chengfengwww/ESC/Hardware/SCH_Schematic1_1-P1_2025-06-22.png

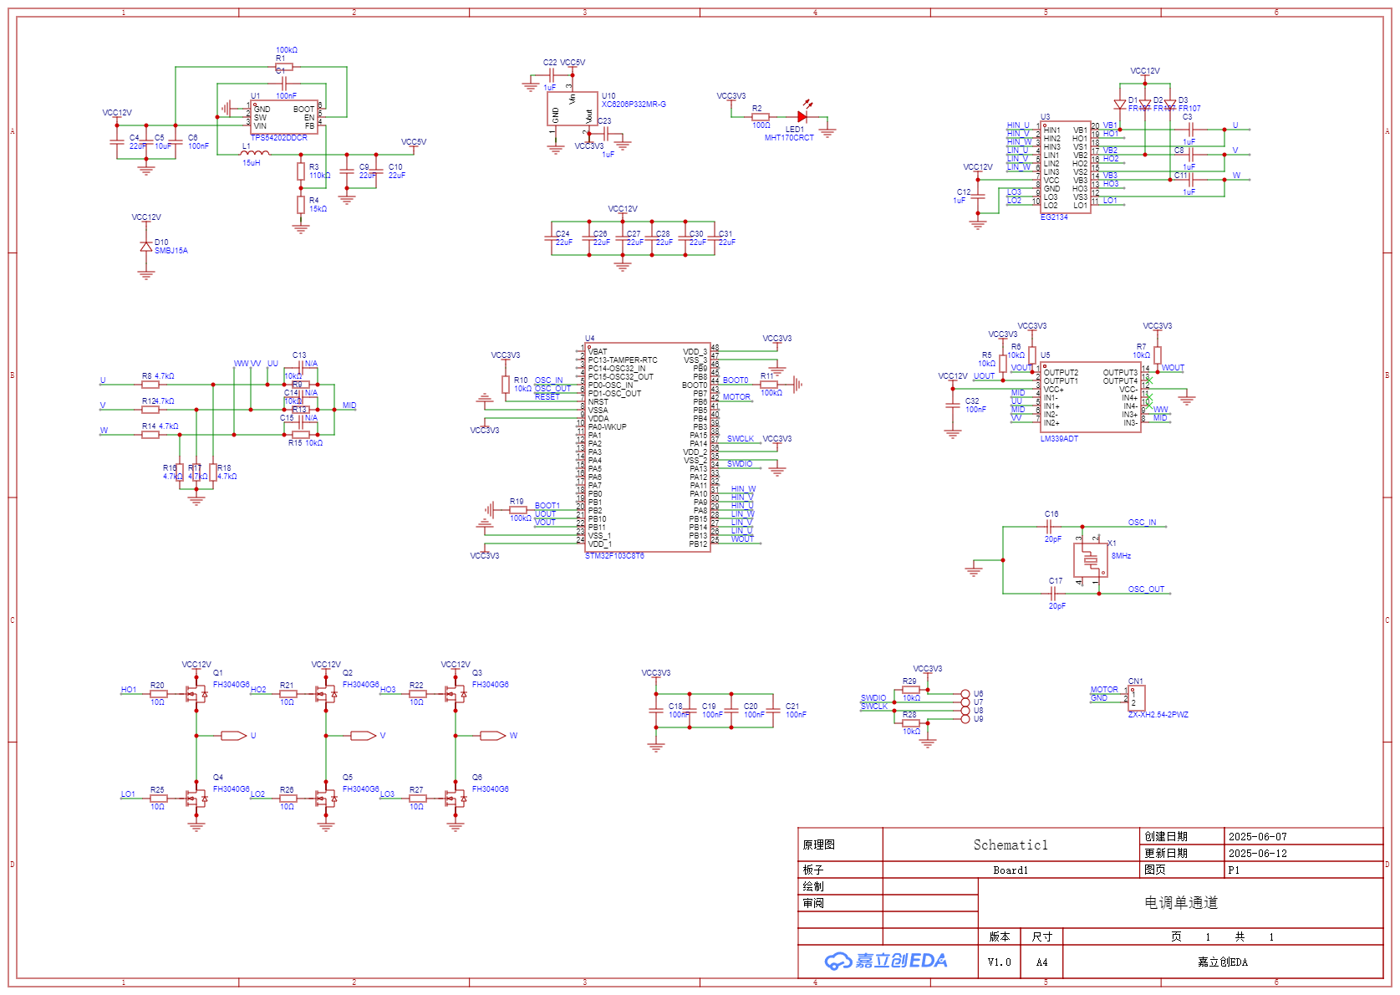
Hardware/SCH_Schematic1_1-P1_2025-06-22.png
