chengfengwww/ESC/(list of files, drawings)

Other design files:
Hardware/电调.eprj
