chengfengwww/ESC/Software/Core/Inc/main.h

#define UOUT_Pin GPIO_PIN_10
#define UOUT_GPIO_Port GPIOB
#define UOUT_EXTI_IRQn EXTI15_10_IRQn
#define VOUT_Pin GPIO_PIN_11
#define VOUT_GPIO_Port GPIOB
#define VOUT_EXTI_IRQn EXTI15_10_IRQn
#define WOUT_Pin GPIO_PIN_12
#define WOUT_GPIO_Port GPIOB
#define WOUT_EXTI_IRQn EXTI15_10_IRQn
#define LIN_U_Pin GPIO_PIN_13
#define LIN_U_GPIO_Port GPIOB
#define LIN_V_Pin GPIO_PIN_14
#define LIN_V_GPIO_Port GPIOB
#define LIN_W_Pin GPIO_PIN_15
#define LIN_W_GPIO_Port GPIOB
#define HIN_U_Pin GPIO_PIN_8
#define HIN_U_GPIO_Port GPIOA
#define HIN_V_Pin GPIO_PIN_9
#define HIN_V_GPIO_Port GPIOA
#define HIN_W_Pin GPIO_PIN_10
#define HIN_W_GPIO_Port GPIOA
