chengfengwww/ESC/(commit log)

2025-06-22 增加硬件说明
2025-06-22 add schematic
